hsa-embedded/elatus/Design/Doc/elatus_V1_front_1.jpg

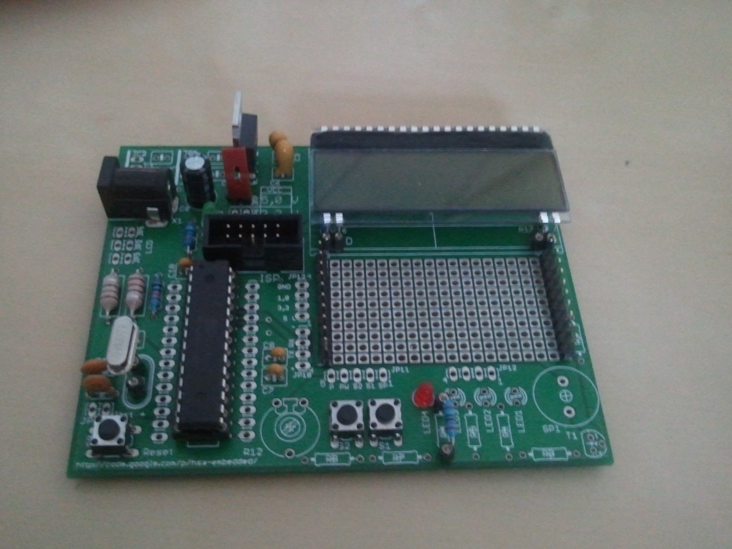
Design/Doc/elatus_V1_front_1.jpg
