hsa-embedded/elatus/Design/Doc/elatus_V1_front_2.jpg

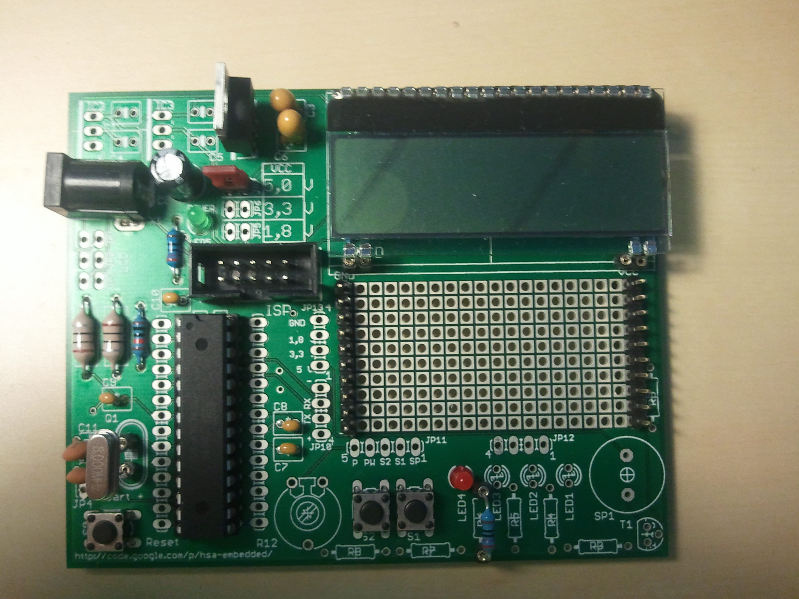
Design/Doc/elatus_V1_front_2.jpg
