hsa-embedded/elatus/Design/Doc/Status_elatus_boards.ods

Board-Nr. | Programmiert ? | Getestet ? | Fehlende Bauteile | Status
1 | nein | nein | 2 Spule, 1,8 Reg, Wid.LED
2 | ja | nein | 1,8 Reg, Wid.-LED
3 | nein | nein | 1 Spule, 1,8 Reg. Wid.-LED
4 | nein | nein | 1 Spule, 1,8 Reg. Wid.-LED
5 | ja | nein | 1,8 Reg. Wid.-LED
6 | nein | nein | 1 Spule, 1,8 Reg. Wid.-LED
7 | nein | nein | 1 Spule, 1,8 Reg. Wid.-LED
 |  |  | Vorgehen:
 |  | 1 | Bauteile bestellen
 |  | 2 | Beschreibung
 |  | 3 | Bauteile montieren
 |  | 4 | programmieren
 |  | 5 | testen
