hsa-embedded/elatus/Design/Doc/Bauteile_Reichelt.ods

 |  |  |  | 19.09.11 | REV: 003
Anz. | Bestellnummer | Kosten (Einzel) | Gesamt | Referenz | Beschreibung
1 | RAD 100/25 | 0,04 | 0,04 | C0 | Elektrolytkondensator, 6,3x11mm, RM 2,5mm
3 | TANTAL 10/25 | 0,21 | 0,63 | C1, C2, C3 | Tantal-Kondensator, Rm 2,5, 10µF/25V
3 | TANTAL 22/16 | 0,28 | 0,84 | C4, C5, C6 | Tantal-Kondensator, Rm 2,5, 22µF/16V
4 | X7R-2,5 100N | 0,06 | 0,24 | C7, C8, C9, C10 | Vielschicht-Keramikkondensator 100N, 10%
2 | KERKO-500 22P | 0,07 | 0,14 | C11, C12 | Keramik-Kondensator, 500V, 22P
2 | SMCC 10µ | 0,19 | 0,38 | L1, L2 | Drosselspule, Festinduktivität, axial, 10µ
1 | 16,0000-HC49U-S | 0,18 | 0,18 | Q1 | Standardquarz, Grundton, 16,0 Mhz
1 | WSL 10G | 0,08 | 0,08 | ISP | Wannenstecker, 10-polig, gerade
1 | SUMMER BJM 05 | 0,45 | 0,45 | SP1 | Schallwandler
1 | BC 337-16 | 0,05 | 0,05 | T1 | Transistor NPN TO-92 45V 0,5A 0,625W
3 | TASTER 9302 | 0,109 | 0,327 | S0, S1, S2 | Kurzhubtaster 6x6mm, Höhe: 5,0mm, 12V, vertikal
1 | HEBW 21 | 0,12 | 0,12 | X1 | Hohlstecker-Einbaubuchse, gewinkelt, Lötfahnen
7 | METALL 10,0K | 0,082 | 0,574 | R2, R7, R10, R11, R13, R14, R15 | Metallschichtwiderstand 10,0 K-Ohm
1 | METALL 1,00K | 0,082 | 0,082 | R9 | Metallschichtwiderstand 1,00 K-Ohm
1 | LED 3MM GN | 0,06 | 0,06 | LED5 | LED, 3mm, Low Cost, grün
1 | METALL 270 | 0,082 | 0,082 | R1 | Metallschichtwiderstand 270 Ohm
1 | JUMPER 2,54GL RT | 0,05 | 0,05 | Vcc schalten | Kurzschlussbrücke, rot, mit Grifflasche
3 | JUMPER 2,54 GN | 0,05 | 0,15 | LCD schalten | Kurzschlussbrücke, grün, RM 2,54, vergoldet
1 | JUMPER 2,54 BL | 0,05 | 0,05 | UART VCC schalten | Kurzschlussbrücke, blau, RM 2,54, vergoldet
1 | PT 10-L 50K | 0,23 | 0,23 | R12 | Einstellpotentiometer, liegend, 10mm, 50 K-Ohm
1 | EA DOGM162W-A | 11,85 | 11,85 | LCD weiß | DOG-Serie 3,3V Hintergrund: weiss
2 | METALL 1,60 | 0,082 | 0,164 | R16, R17 | Metallschichtwiderstand 1,60 Ohm
1 | TANTAL 1,0/35 | 0,14 | 0,14 | C15 | Tantal-Kondensator, Rm 2,5, 1,0µF/35V
1 | TANTAL 0,22/35 | 0,14 | 0,14 | C14 | Tantal-Kondensator, Rm 2,5, 0,22µF/35V
2 | SL 1X40G 2,54 | 0,14 | 0,28 | Uart,Jumper, VCC/GND Leisten, etc. | 40pol. Stiftleiste, gerade, RM 2,54
1 | GS 28P-S | 0,42 | 0,42 |  | IC-Sockel,28-polig,superflach,gedreht,vergold,schmal
4 | LED 3MM RT | 0,06 | 0,24 | LED1, LED2, LED3, LED4 | LED, 3mm, Low Cost, rot
1 | EA LED55X31-W | 10,35 | 10,35 |  | Led-Beleuchtung für EA DOGM..Farbe: weiss
1 | LM 1117 T5,0 | 0,99 | 0,99 |  | Low-Drop Spannungsregler, 5 V, TO-220
1 | LM 1117 T3,3 | 0,95 | 0,95 |  | Low-Drop Spannungsregler, 3.3 V, TO-220
4 | METALL 100 | 0,082 | 0,328 | R3, R4, R5, R6 | Metallschichtwiderstand 100 Ohm
 |  | Gesamt: | 30,607 | Alle Preis in €
 | Display
1 | EA DOGM162B-A |  |  | LCD blau | DOG-Serie 3,3V Hintergrund: blau
