hsa-embedded/elatus/Design/Doc/Bauteile_Farnell.ods

Anz. | Bestellnummer | Kosten (Einzel) | Gesamt | Referenz | Beschreibung | Hinweis
1 | 1636950 | 2,38 | 2,38 | IC1 | ATMEGA88PV-10PU - 8-BIT MCU | bei Abnahme von 10
 |  | Gesamt: | 2,38 | Alle Preis in €
