hsa-embedded/elatus/Design/Doc/Bauteile_RS-Componets.ods

Anz. | Bestellnummer | Kosten (Einzel) | Gesamt | Referenz | Beschreibung | Hinweis
1 | 696-2308 | 2,78 | 2,78 | IC1 | ATMEGA88PV-10PU | bei Abnahme von 10 | NICHT VORHANDEN
1 | 535-9256 | 1,658 | 1,658 | IC3 | LM1117T-3.3/NOPB | min. Abnahme 5
1 | 535-9262 | 1,54 | 1,54 | IC4 | LM1117T-5.0/NOPB | min. Abnahme 5
1 | 535-8691 | 1,056 | 1,056 | IC2 | LM1117T-1.8/NOPB | min. Abnahme 5
 |  | Gesamt: | 7,034 | Alle Preis in €
