hsa-embedded/elatus/Design/elatus.brd

## EAGLE design Design/elatus.brd (2015-01-07)

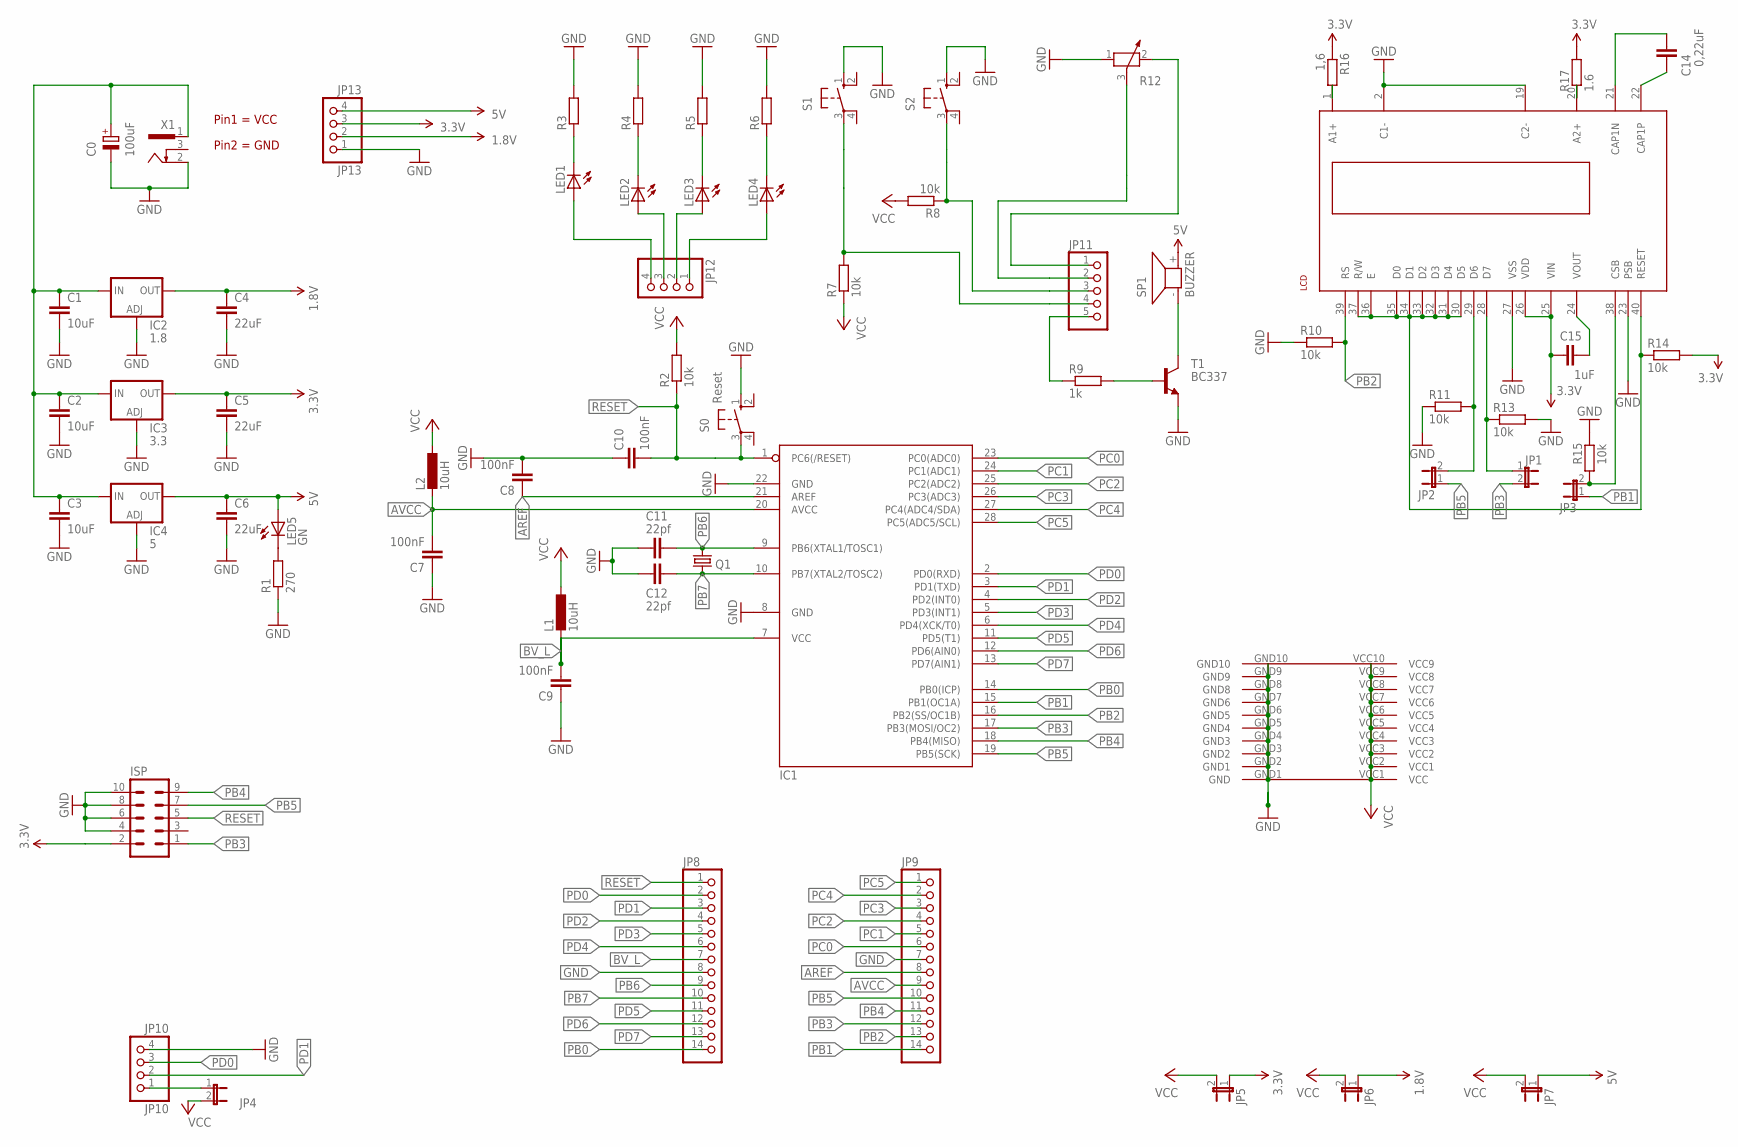
[picture p3: schematic elatus.sch]

Parts:
C0: 100uF; RCL_E2,5-7
C1, C2, C3: 10uF; RCL_C025-040X050
C4, C5, C6: 22uF; RCL_C025-040X050
C7, C8, C9, C10: 100nF; RCL_C025-040X050
C11, C12: 22pf; RESISTOR_C050-024X044
C14: 0,22uF; RCL_C025-040X050
C15: 1uF; RCL_C025-040X050
IC1: MEGA8-P; DIL28-3
IC2: 1.8; TO220V
IC3: 3.3; TO220V
IC4: 5; TO220V
ISP: CON-HARTING-ML_ML10
JP1, JP2, JP3, JP4, JP5, JP6, JP7: JP1E; JP1
JP8, JP9: PINHD-1X14; 1X14
JP10: JP10; 1X04
JP11: PINHD-1X5; 1X05
JP12: PINHD-1X4; 1X04
JP13: JP13; 1X04
L1, L2: 10uH; RCL_2200-12.7
LCD: -OPTO_DOGM
LED1, LED2, LED3, LED4: LED_LED3MM
LED5: GN; LED_LED3MM
Q1: CRYSTAL_CRYSTALHC49U70; CRYSTAL_HC49U70
R1: 270; 0207/10
R2, R7, R8, R10, R11, R13, R14, R15: 10k; 0207/10
R3, R4, R5, R6: R-EU_0207/10; 0207/10
R9: 1k; 0207/10
R12: POTENTIOMETER_PT-10; PT-10
R16: 1,6; 0207/10
R17: 1.6; 0207/10
S0: Reset; SWITCH-OMRON_B3F-10XX
S1, S2: SWITCH-OMRON_10-XX; SWITCH-OMRON_B3F-10XX
SP1: BUZZER; BUZZER_F/PMX04A
T1: BC337; TO92
U$3: JP5; RASTER_2_54
X1: CON-CONRAD_733980-62

Connections:
1.8V: C4.1, IC2.2 (OUT), JP6.1, JP13.2
3.3V: C5.1, C15.2, IC3.2 (OUT), ISP.2, JP5.1, JP13.3, LCD.25 (VIN), LCD.26 (VDD), R14.2, R16.1, R17.2
5V: C6.1, IC4.2 (OUT), JP7.1, JP13.4, LED5.A, SP1.+ (2)
AREF: C8.1, IC1.21 (AREF), JP9.8
AVCC: C7.2, IC1.20 (AVCC), JP9.9, L2.2
BV_L: C9.2, IC1.7 (VCC), JP8.7, L1.2
GND: C0.-, C1.2, C2.2, C3.2, C4.2, C5.2, C6.2, C7.1, C8.2, C9.1, C10.1, C11.1, C12.1, IC1.8 (GND), IC1.22 (GND), IC2.1 (ADJ), IC3.1 (ADJ), IC4.1 (ADJ), ISP.4, ISP.6, ISP.8, ISP.10, JP8.8, JP9.7, JP10.4, JP13.1, LCD.2 (C1-), LCD.19 (C2-), LCD.23 (PSB), LCD.27 (VSS), R1.1, R3.2, R4.2, R5.2, R6.2, R10.1, R11.1, R12.1, R13.2, R15.2, S0.1 (S), S1.1 (S), S2.1 (S), T1.1 (E), U$3.GND1 (GND), U$3.GND2 (GND1), U$3.GND3 (GND2), U$3.GND4 (GND3), U$3.GND5 (GND4), U$3.GND6 (GND5), U$3.GND7 (GND6), U$3.GND8, U$3.GND9, U$3.GND10, X1.2
unnamed: LED1.K (C), R3.1
unnamed: LED2.K (C), R4.1
unnamed: JP11.2, R12.3
unnamed: LED3.K (C), R5.1
unnamed: JP11.4, R7.2, S1.3
unnamed: JP12.4, LED1.A
unnamed: JP11.3, R8.1, S2.3
unnamed: LED4.K (C), R6.1
unnamed: JP11.1, R12.2
unnamed: JP12.3, LED2.A
unnamed: JP2.2, LCD.29 (D6), R11.2
unnamed: JP1.1, LCD.28 (D7), R13.1
unnamed: LED5.K (C), R1.2
unnamed: JP4.1, JP10.1
unnamed: JP12.2, LED3.A
unnamed: JP11.5, R9.1
unnamed: JP12.1, LED4.A
unnamed: SP1.- (1), T1.3 (C)
unnamed: LCD.20 (A2+), R17.1
unnamed: C14.2, LCD.21 (CAP1N)
unnamed: C14.1, LCD.22 (CAP1P)
unnamed: C0.+, C1.1, C2.1, C3.1, IC2.3 (IN), IC3.3 (IN), IC4.3 (IN), X1.1
unnamed: LCD.1 (A1+), R16.2
unnamed: LCD.30 (D5), LCD.31 (D4), LCD.32 (D3), LCD.33 (D2), LCD.34 (D1), LCD.35 (D0), LCD.36 (E), LCD.37 (R/W), LCD.40 (RESET), R14.1
unnamed: R9.2, T1.2 (B)
unnamed: C15.1, LCD.24 (VOUT)
unnamed: JP3.2, LCD.38 (CSB), R15.1
PB0: IC1.14 (PB0(ICP)), JP8.14
PB1: IC1.15 (PB1(OC1A)), JP3.1, JP9.14
PB2: IC1.16 (PB2(SS/OC1B)), JP9.13, LCD.39 (RS), R10.2
PB3: IC1.17 (PB3(MOSI/OC2)), ISP.1, JP1.2, JP9.12
PB4: IC1.18 (PB4(MISO)), ISP.9, JP9.11
PB5: IC1.19 (PB5(SCK)), ISP.7, JP2.1, JP9.10
PB6: C11.2, IC1.9 (PB6(XTAL1/TOSC1)), JP8.9, Q1.2
PB7: C12.2, IC1.10 (PB7(XTAL2/TOSC2)), JP8.10, Q1.1
PC0: IC1.23 (PC0(ADC0)), JP9.6
PC1: IC1.24 (PC1(ADC1)), JP9.5
PC2: IC1.25 (PC2(ADC2)), JP9.4
PC3: IC1.26 (PC3(ADC3)), JP9.3
PC4: IC1.27 (PC4(ADC4/SDA)), JP9.2
PC5: IC1.28 (PC5(ADC5/SCL)), JP9.1
PD0: IC1.2 (PD0(RXD)), JP8.2, JP10.3
PD1: IC1.3 (PD1(TXD)), JP8.3, JP10.2
PD2: IC1.4 (PD2(INT0)), JP8.4
PD3: IC1.5 (PD3(INT1)), JP8.5
PD4: IC1.6 (PD4(XCK/T0)), JP8.6
PD5: IC1.11 (PD5(T1)), JP8.11
PD6: IC1.12 (PD6(AIN0)), JP8.12
PD7: IC1.13 (PD7(AIN1)), JP8.13
RESET: C10.2, IC1.1 (PC6(/RESET)), ISP.5, JP8.1, R2.1, S0.3
VCC: JP4.2, JP5.2, JP6.2, JP7.2, L1.1, L2.1, R2.2, R7.1, R8.2, U$3.VCC1 (VCC), U$3.VCC2 (VCC1), U$3.VCC3 (VCC2), U$3.VCC4 (VCC3), U$3.VCC5 (VCC4), U$3.VCC6 (VCC5), U$3.VCC7 (VCC6), U$3.VCC8 (VCC7), U$3.VCC9 (VCC8), U$3.VCC10 (VCC9)

Notes on the sheet:
Pin1 = VCC
Pin2 = GND

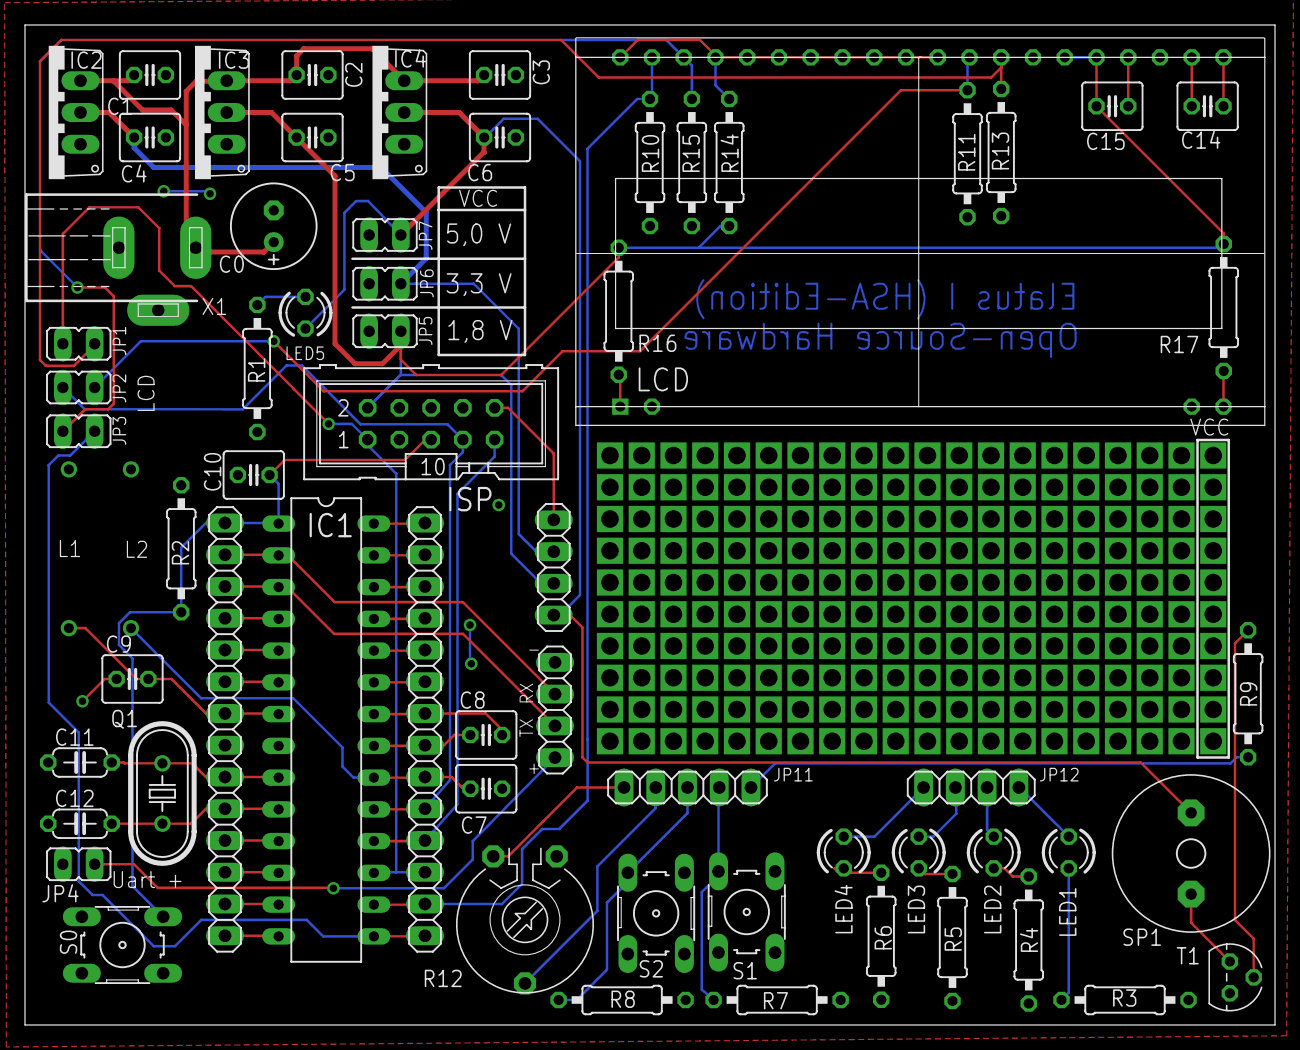
[picture p4: board elatus.brd from above]

Board: 2 copper layers, 100.0 x 80.0 mm, 66 parts (0 on the bottom side), 58 nets.
