hsa-embedded/elatus/Software/Projekte/GNUblin/elatus/main.h

#ifndef _MAIN_H_
#define _MAIN_H_

     /* Includes: */
     #include <util/delay.h>

     //Elatus
      //LED
     #include "../../../ELATUS/Treiber/Peripherie/led.h"
      //i2c_slave
     #include "../../../ELATUS/Treiber/Schnittstellen/i2c_slave.h"
      //lcd
     #include "../../../ELATUS/Treiber/Peripherie/lcd.h"
      //Uart
     #include "../../../ELATUS/Treiber/Schnittstellen/uart.h"

     /* Makros: */

     /* Functions: */
     void SetupHardware(void);

     /* Inline Funktionen: */
   


#endif
