hsa-embedded/elatus/Software/ELATUS/Allgemein/time.h

// Wird noch nicht gebraucht



#ifndef _TIME_H_
#define _TIME_H_
     /* Includes: */
      
     #include <utile/delay.h>
     #include <
     #include "elatus.h"
     
     /* Funktions: */
     void sleep_ms(uint16_t Time){
       while(Time--){
	 _delay_ms
       }
     }

      

#endif
