hsa-embedded/elatus/Software/ELATUS/Treiber/Peripherie/adw.c

#include "adw.h"

ISR(ADC_vect)
{
   cli();                                        // IRQs global sperren
   char tmp_string[TMP_BUFSIZE];
   uint16_t adc_value;                           // Wert aus Analog-Digital-Wandler
   uint8_t lowbyte, highbyte;
   lowbyte = ADCL;                               // hole zuerst low_Byte
   highbyte = ADCH;                              // danach high_Byte
                                                 // und fuege dann beide zusammen
   adc_value = highbyte;
   adc_value <<= 8;
   adc_value |= lowbyte;
   EVENT_ADW_getvalue(adc_value);
   sei();                                        // Interrupts global wieder frei geben
}
